Synt4xErr0r4/syntaxkbd/schem/KeyboardV2_Controller.kicad_pcb

## KiCad design schem/KeyboardV2_Controller.kicad_pcb (2026-10-29)

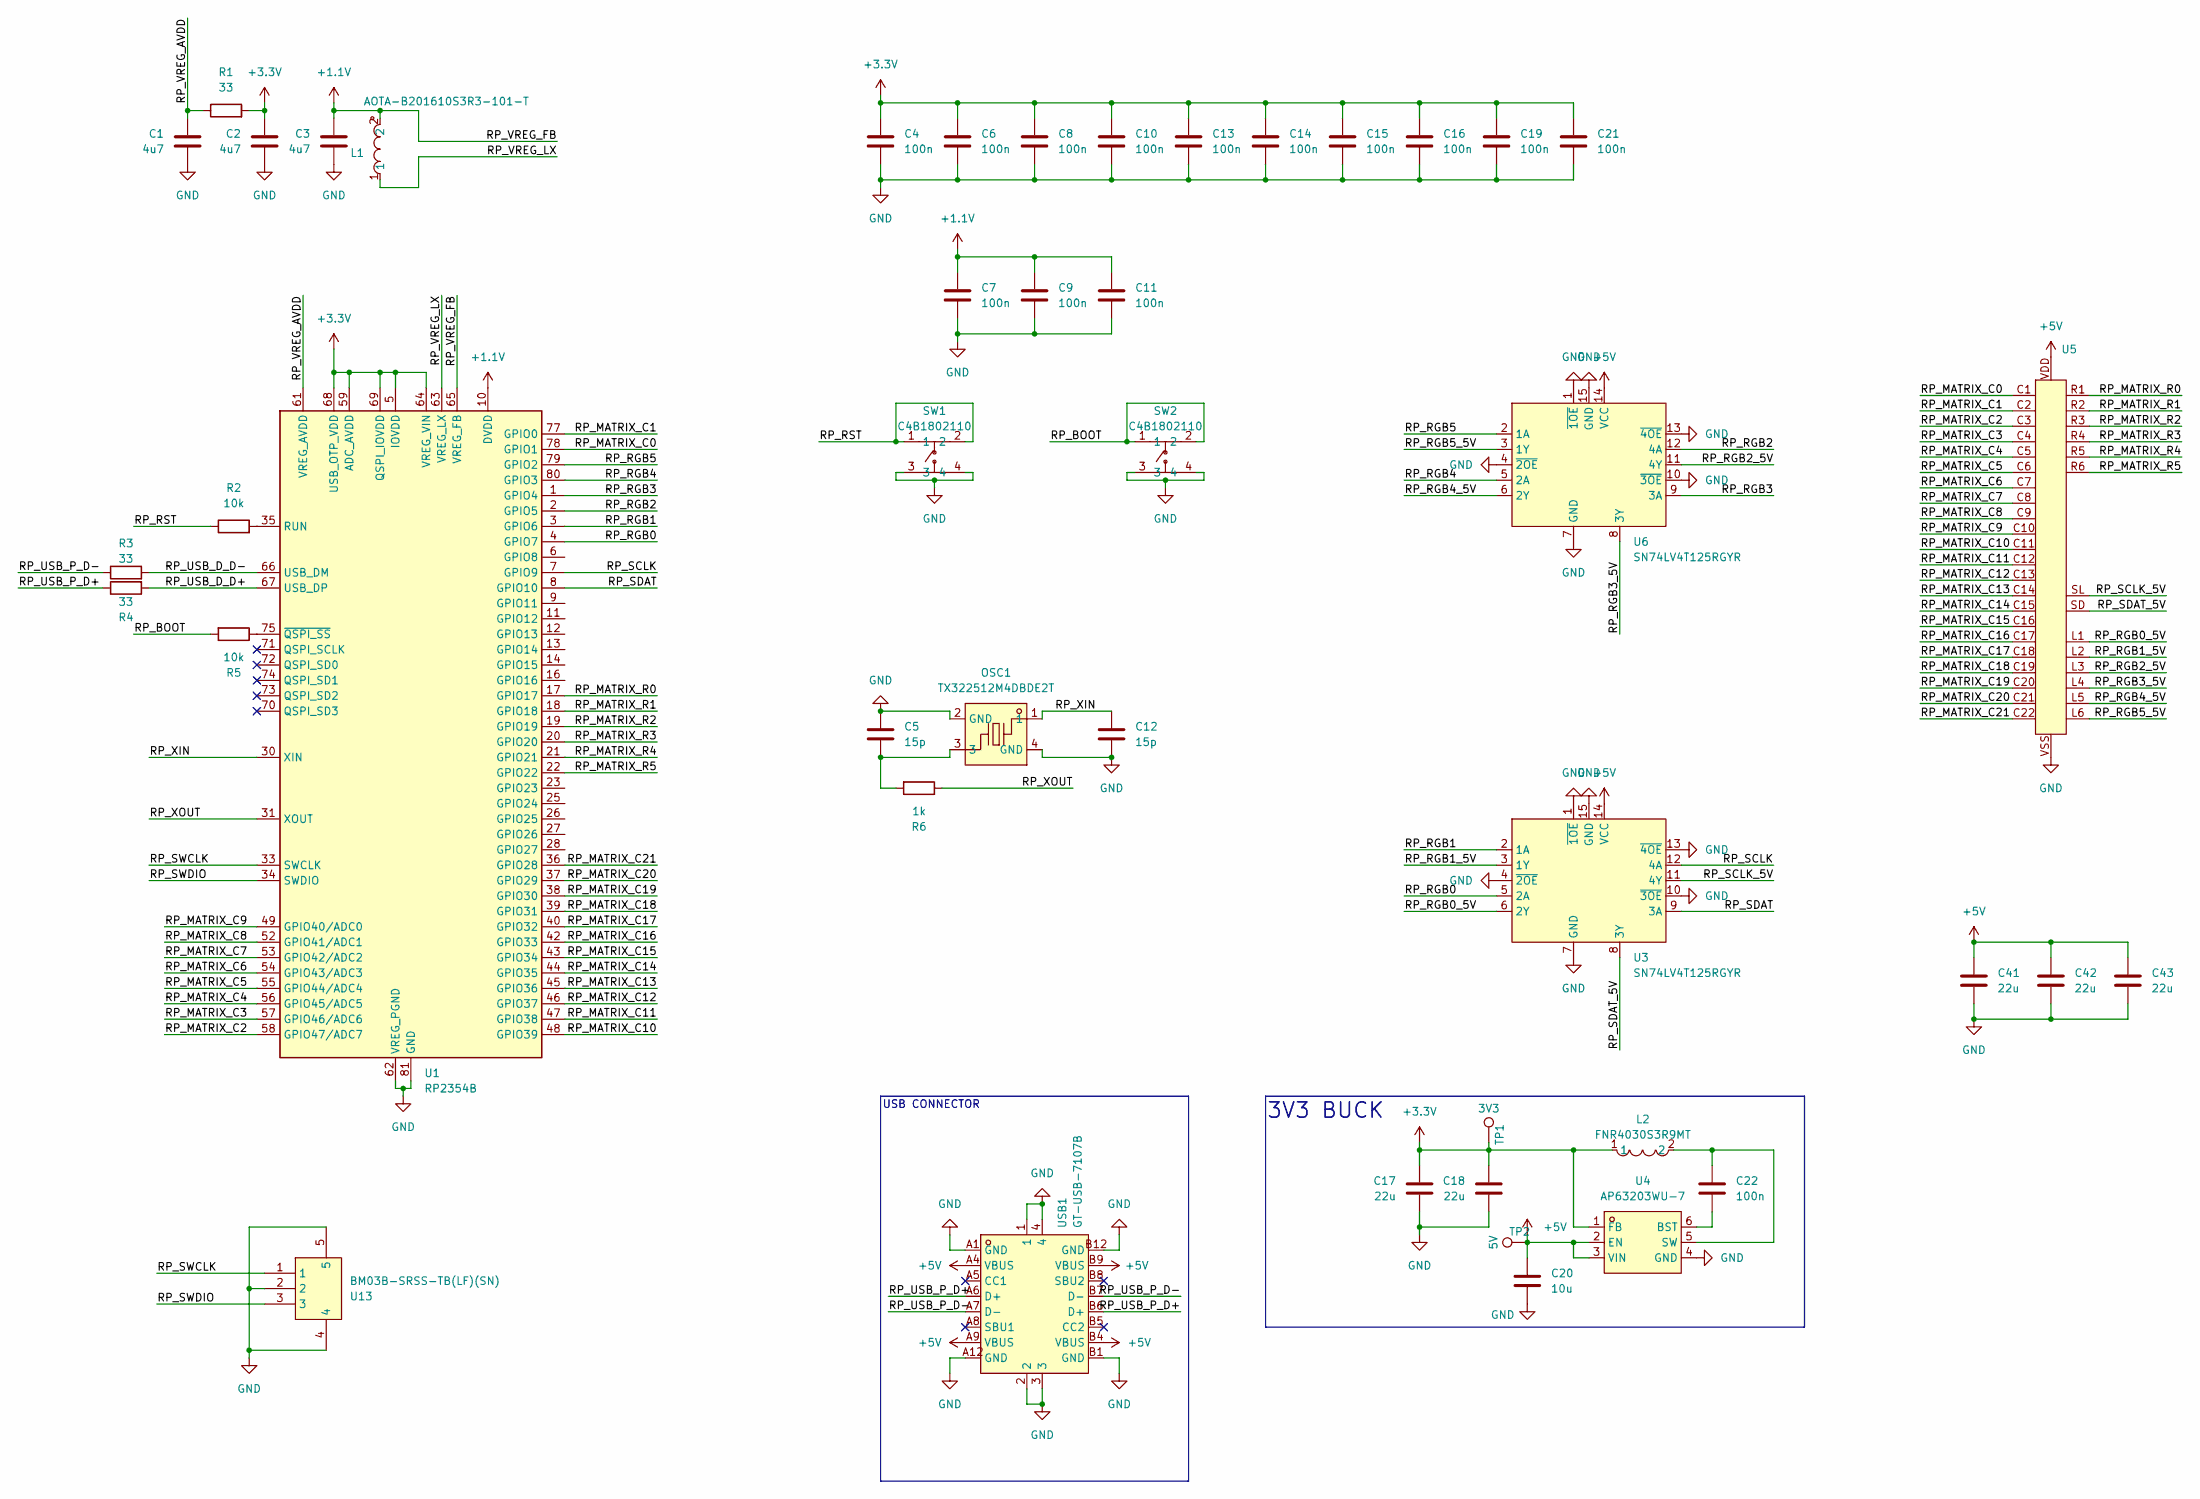
[picture p10: schematic KeyboardV2_Controller.kicad_sch]

Parts:
C1, C2, C3: 4u7; C_0402_1005Metric; LCSC Part C368809
C4, C6, C7, C8, C9, C10, C11, C13, C14, C15, C16, C19, C21, C22: 100n; C_0402_1005Metric; LCSC Part C60474
C5, C12: 15p; C_0402_1005Metric; LCSC Part C326803
C17, C18: 22u; C_1206_3216Metric; LCSC Part C12891
C20: 10u; C_0805_2012Metric; LCSC Part C15850
C41, C42, C43: 22u; C_0805_2012Metric; LCSC Part C602037
L1: AOTA-B201610S3R3-101-T; IND-SMD_L2.0-W1.6_AOTA-B201610S3R3-101-T; LCSC Part C42411119
L2: FNR4030S3R9MT; IND-SMD_L4.0-W4.0_FNR40XXS; LCSC Part C167872
OSC1: TX322512M4DBDE2T; OSC-SMD_4P-L3.2-W2.5-BL; LCSC Part C5310728
R1, R3, R4: 33; R_0402_1005Metric; LCSC Part C7273719
R2, R5: 10k; R_0402_1005Metric; LCSC Part C60490
R6: 1k; R_0402_1005Metric; LCSC Part C106235
SW1, SW2: C4B1802110; SW-SMD_4P-L3.5-W3.0-P1.50-LS4.7; LCSC Part C49393608
TP1: 3V3; TestPoint_Pad_D2.0mm
TP2: 5V; TestPoint_Pad_D2.0mm
U1: RP2354B; QFN-80-1EP_10x10mm_P0.4mm_EP3.4x3.4mm; LCSC Part C39843328
U3, U6: SN74LV4T125RGYR; VQFN-14_L3.5-W3.5-P0.50-BL-EP; LCSC Part C411879
U4: AP63203WU-7; TSOT-26_L2.9-W1.6-P0.95-LS2.8-BL; LCSC Part C780769
U5: KBDCTRL_Conn
U13: BM03B-SRSS-TB(LF)(SN); CONN-SMD-3P-P1.00_BM03B-SRSS-TB-LF-SN; LCSC Part C160389
USB1: GT-USB-7107B; USB-C-TH_GT-USB-7107B; LCSC Part C49302689

Connections:
+1.1V: C3.1, C7.1, C9.1, C11.1, L1.2, U1.10 (DVDD), U1.32 (DVDD), U1.51 (DVDD), U1.65 (VREG_FB)
+3.3V: C2.1, C4.1, C6.1, C8.1, C10.1, C13.1, C14.1, C15.1, C16.1, C17.1, C18.1, C19.1, C21.1, L2.1, R1.2, TP1.1, U1.5 (IOVDD), U1.15 (IOVDD), U1.24 (IOVDD), U1.29 (IOVDD), U1.41 (IOVDD), U1.50 (IOVDD), U1.59 (ADC_AVDD), U1.60 (IOVDD), U1.64 (VREG_VIN), U1.68 (USB_OTP_VDD), U1.69 (QSPI_IOVDD), U1.76 (IOVDD), U4.1 (FB)
+5V: C20.1, C41.1, C42.1, C43.1, TP2.1, U3.14 (VCC), U4.2 (EN), U4.3 (VIN), U5.VDD, U6.14 (VCC), USB1.A4 (VBUS), USB1.A9 (VBUS), USB1.B4 (VBUS), USB1.B9 (VBUS)
/RP_BOOT: R5.2, SW2.1, SW2.2
/RP_MATRIX_C0: U1.78 (GPIO1), U5.C1
/RP_MATRIX_C1: U1.77 (GPIO0), U5.C2
/RP_MATRIX_C2: U1.58 (GPIO47/ADC7), U5.C3
/RP_MATRIX_C3: U1.57 (GPIO46/ADC6), U5.C4
/RP_MATRIX_C4: U1.56 (GPIO45/ADC5), U5.C5
/RP_MATRIX_C5: U1.55 (GPIO44/ADC4), U5.C6
/RP_MATRIX_C6: U1.54 (GPIO43/ADC3), U5.C7
/RP_MATRIX_C7: U1.53 (GPIO42/ADC2), U5.C8
/RP_MATRIX_C8: U1.52 (GPIO41/ADC1), U5.C9
/RP_MATRIX_C9: U1.49 (GPIO40/ADC0), U5.C10
/RP_MATRIX_C10: U1.48 (GPIO39), U5.C11
/RP_MATRIX_C11: U1.47 (GPIO38), U5.C12
/RP_MATRIX_C12: U1.46 (GPIO37), U5.C13
/RP_MATRIX_C13: U1.45 (GPIO36), U5.C14
/RP_MATRIX_C14: U1.44 (GPIO35), U5.C15
/RP_MATRIX_C15: U1.43 (GPIO34), U5.C16
/RP_MATRIX_C16: U1.42 (GPIO33), U5.C17
/RP_MATRIX_C17: U1.40 (GPIO32), U5.C18
/RP_MATRIX_C18: U1.39 (GPIO31), U5.C19
/RP_MATRIX_C19: U1.38 (GPIO30), U5.C20
/RP_MATRIX_C20: U1.37 (GPIO29), U5.C21
/RP_MATRIX_C21: U1.36 (GPIO28), U5.C22
/RP_MATRIX_R0: U1.17 (GPIO17), U5.R1
/RP_MATRIX_R1: U1.18 (GPIO18), U5.R2
/RP_MATRIX_R2: U1.19 (GPIO19), U5.R3
/RP_MATRIX_R3: U1.20 (GPIO20), U5.R4
/RP_MATRIX_R4: U1.21 (GPIO21), U5.R5
/RP_MATRIX_R5: U1.22 (GPIO22), U5.R6
/RP_RGB0: U1.4 (GPIO7), U3.5 (2A)
/RP_RGB0_5V: U3.6 (2Y), U5.L1
/RP_RGB1: U1.3 (GPIO6), U3.2 (1A)
/RP_RGB1_5V: U3.3 (1Y), U5.L2
/RP_RGB2: U1.2 (GPIO5), U6.12 (4A)
/RP_RGB2_5V: U5.L3, U6.11 (4Y)
/RP_RGB3: U1.1 (GPIO4), U6.9 (3A)
/RP_RGB3_5V: U5.L4, U6.8 (3Y)
/RP_RGB4: U1.80 (GPIO3), U6.5 (2A)
/RP_RGB4_5V: U5.L5, U6.6 (2Y)
/RP_RGB5: U1.79 (GPIO2), U6.2 (1A)
/RP_RGB5_5V: U5.L6, U6.3 (1Y)
/RP_RST: R2.1, SW1.1, SW1.2
/RP_SCLK: U1.7 (GPIO9), U3.12 (4A)
/RP_SCLK_5V: U3.11 (4Y), U5.SL
/RP_SDAT: U1.8 (GPIO10), U3.9 (3A)
/RP_SDAT_5V: U3.8 (3Y), U5.SD
/RP_SWCLK: U1.33 (SWCLK), U13.1
/RP_SWDIO: U1.34 (SWDIO), U13.3
/RP_USB_D_D+: R4.2, U1.67 (USB_DP)
/RP_USB_D_D-: R3.2, U1.66 (USB_DM)
/RP_USB_P_D+: R4.1, USB1.A6 (D+), USB1.B6 (D+)
/RP_USB_P_D-: R3.1, USB1.A7 (D-), USB1.B7 (D-)
/RP_VREG_AVDD: C1.1, R1.1, U1.61 (VREG_AVDD)
/RP_VREG_LX: L1.1, U1.63 (VREG_LX)
/RP_XIN: C12.1, OSC1.1, U1.30 (XIN)
/RP_XOUT: R6.1, U1.31 (XOUT)
GND: C1.2, C2.2, C3.2, C4.2, C5.1, C6.2, C7.2, C8.2, C9.2, C10.2, C11.2, C12.2, C13.2, C14.2, C15.2, C16.2, C17.2, C18.2, C19.2, C20.2, C21.2, C41.2, C42.2, C43.2, OSC1.2 (GND), OSC1.4 (GND), SW1.3, SW1.4, SW2.3, SW2.4, U1.62 (VREG_PGND), U1.81 (GND), U3.1 (~1OE), U3.4 (~2OE), U3.7 (GND), U3.10 (~3OE), U3.13 (~4OE), U3.15 (GND), U4.4 (GND), U5.VSS, U6.1 (~1OE), U6.4 (~2OE), U6.7 (GND), U6.10 (~3OE), U6.13 (~4OE), U6.15 (GND), U13.2, U13.4, U13.5, USB1.1, USB1.2, USB1.3, USB1.4, USB1.A1 (GND), USB1.A12 (GND), USB1.B1 (GND), USB1.B12 (GND)
unnamed: C5.2, OSC1.3, R6.2
unnamed: R2.2, U1.35 (RUN)
unnamed: R5.1, U1.75 (~QSPI_SS)
unnamed: C22.2, U4.6 (BST)
unnamed: C22.1, L2.2, U4.5 (SW)

Notes on the sheet:
3V3 BUCK
USB CONNECTOR

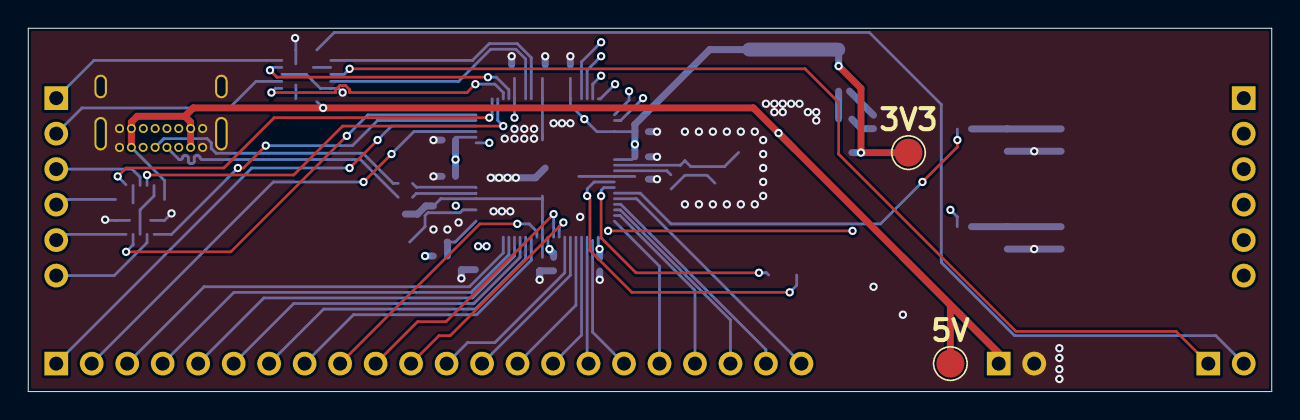
[picture p11: board KeyboardV2_Controller.kicad_pcb from above]

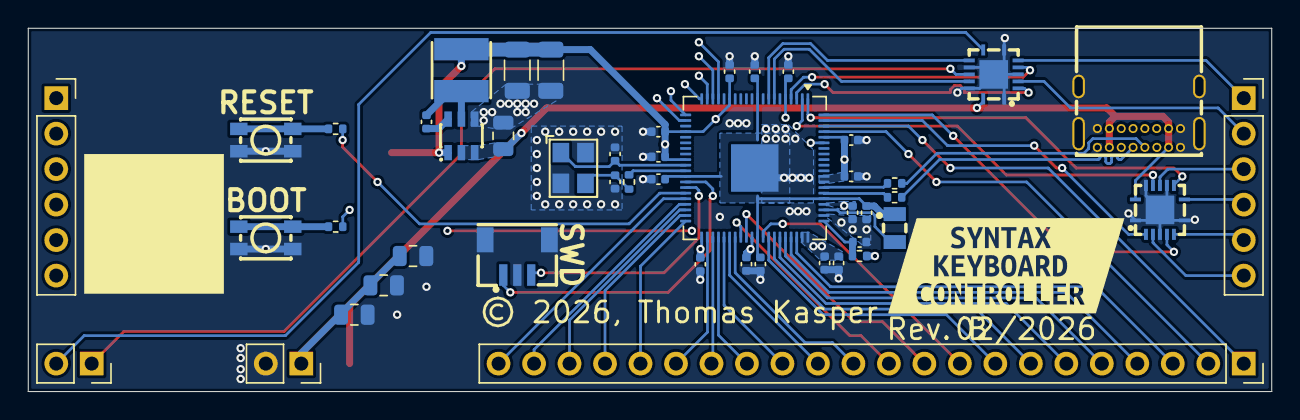
[picture p12: board KeyboardV2_Controller.kicad_pcb from below]

Board: 4 copper layers, 89.0 x 26.0 mm, 46 parts (43 on the bottom side), 65 nets.

Other parts of the board:
kibuzzard-699F86BB: G***; kibuzzard-699F86BB
