Synt4xErr0r4/syntaxkbd/fw/tusb_config.h

#ifndef _TUSB_CONFIG_H
#define _TUSB_CONFIG_H

#ifdef __cplusplus
extern "C" {
#endif

#ifndef BOARD_TUD_MAX_SPEED
# define BOARD_TUD_MAX_SPEED OPT_MODE_DEFAULT_SPEED
#endif

#ifndef BOARD_TUD_RHPORT
# define BOARD_TUD_RHPORT 0
#endif

#ifndef CFG_TUSB_MCU
# error "CFG_TUSB_MCU not defined"
#endif

#ifndef CFG_TUSB_OS
# define CFG_TUSB_OS OPT_OS_NONE
#endif

#ifndef CFG_TUSB_DEBUG
# define CFG_TUSB_DEBUG 0
#endif

#define CFG_TUD_ENABLED 1

#define CFG_TUD_MAX_SPEED BOARD_TUD_MAX_SPEED

#ifndef CFG_TUSB_MEM_SECTION
# define CFG_TUSB_MEM_SECTION
#endif

#ifndef CFG_TUD_MEM_ALIGN
# define CFG_TUD_MEM_ALIGN __attribute__((aligned(4)))
#endif

#ifndef CFG_TUD_ENDPOINT0_SIZE
# define CFG_TUD_ENDPOINT0_SIZE 64
#endif

#define CFG_TUD_HID 2
#define CFG_TUD_CDC 1
#define CFG_TUD_MSC 0
#define CFG_TUD_MIDI 0
#define CFG_TUD_VENDOR 1

#define CFG_TUD_HID_EP_BUFSIZE 64
#define CFG_TUD_CDC_NOTIF_BUFSIZE 16
#define CFG_TUD_CDC_TX_BUFSIZE 64
#define CFG_TUD_CDC_RX_BUFSIZE 64
#define CFG_TUD_CDC_EP_BUFSIZE 64
#define CFG_TUD_VENDOR_TX_BUFSIZE 64
#define CFG_TUD_VENDOR_RX_BUFSIZE 64
#define CFG_TUD_VENDOR_EP_BUFSIZE 64

#ifdef __cplusplus
}
#endif

#endif
