Synt4xErr0r4/syntaxkbd/(notices)

Notices in the files:
schem/KeyboardV2_Controller.kicad_pcb:
© 2026, Thomas Kasper
